EstebanUnal-Hub/VLSI-UNAL/Documents/ASIC_Flow/Bloques.png

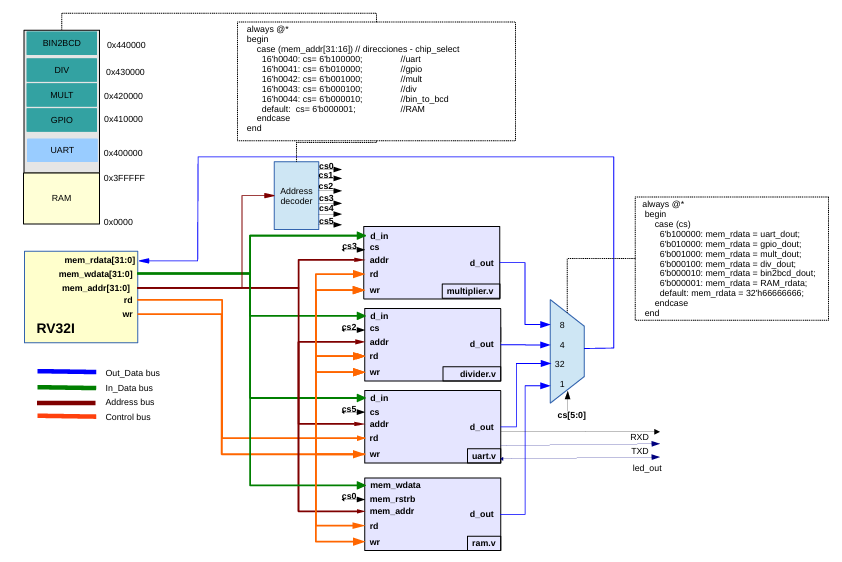
Documents/ASIC_Flow/Bloques.png
