EstebanUnal-Hub/VLSI-UNAL/Documents/Mult_4/Commands_Magis.png

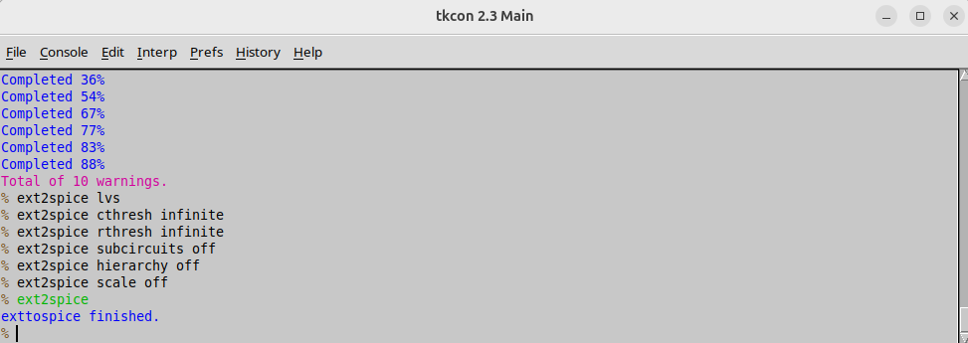
Documents/Mult_4/Commands_Magis.png
