EstebanUnal-Hub/VLSI-UNAL/Documents/SPICE/commands.png

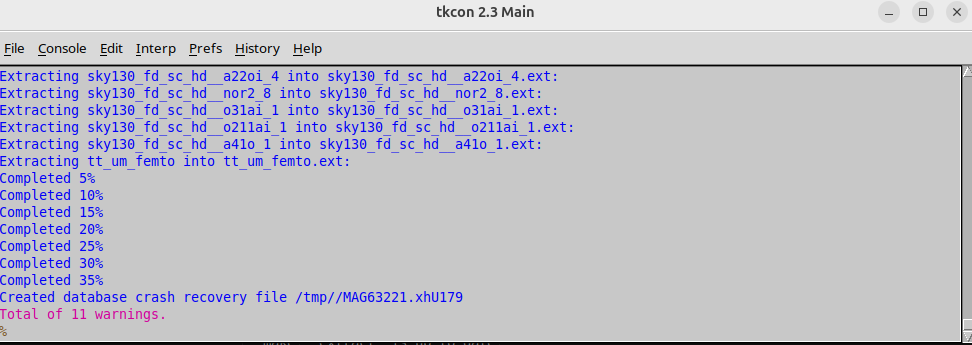
Documents/SPICE/commands.png
