EstebanUnal-Hub/VLSI-UNAL/Documents/SPICE/Otras.png

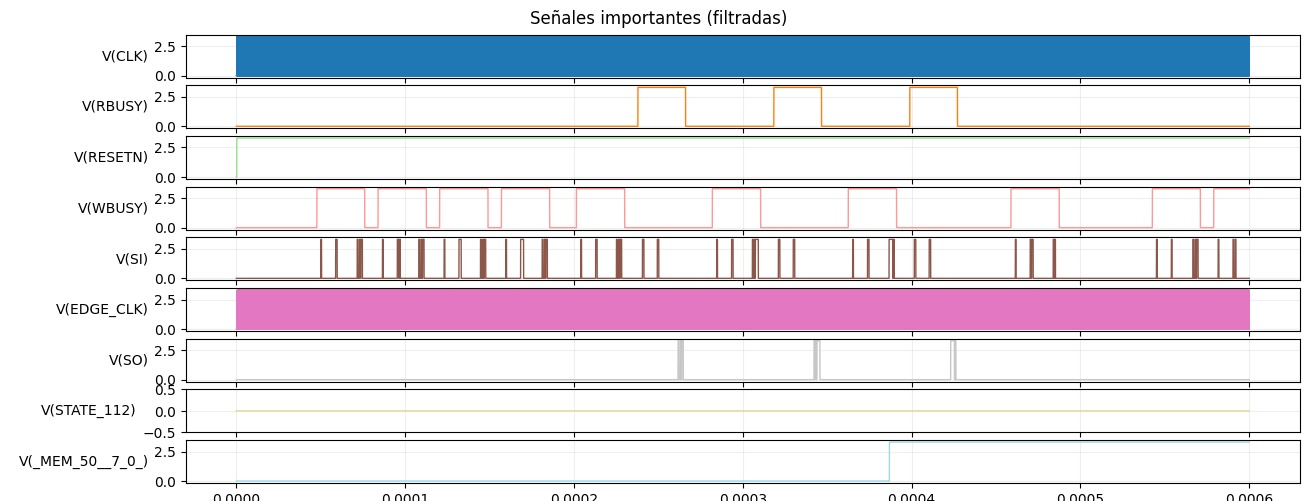
Documents/SPICE/Otras.png
