EstebanUnal-Hub/VLSI-UNAL/Documents/SPICE/PC.png

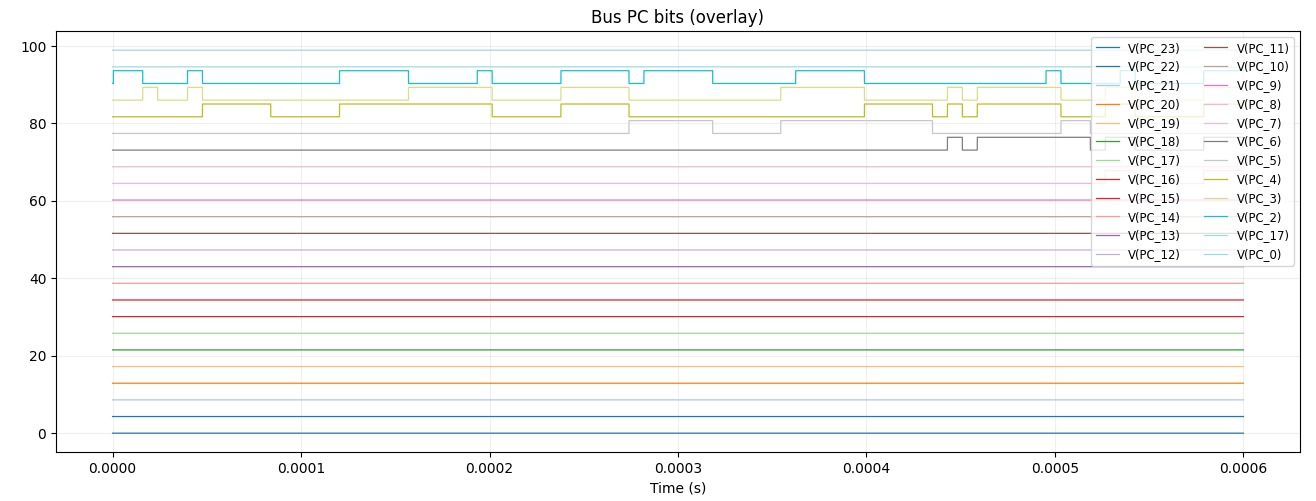
Documents/SPICE/PC.png
