EstebanUnal-Hub/VLSI-UNAL/Documents/SPICE/PC_INT.png

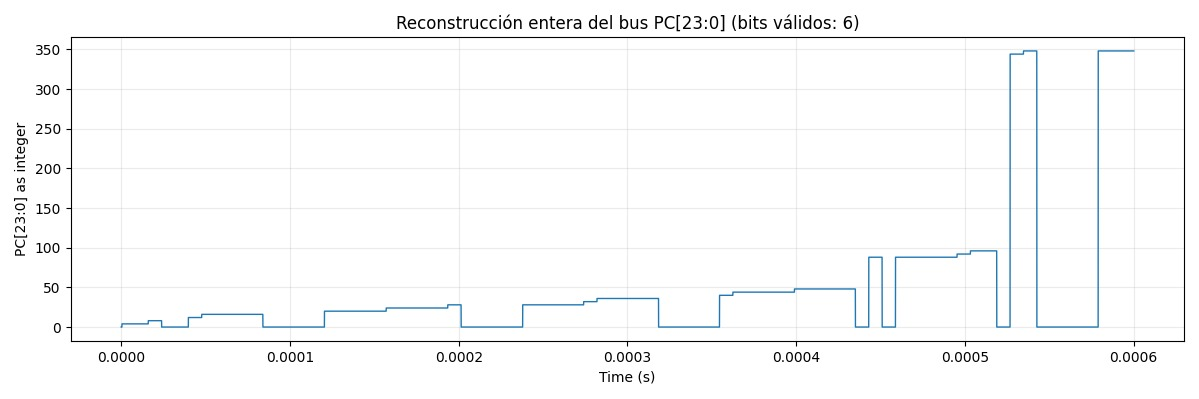
Documents/SPICE/PC_INT.png
