EstebanUnal-Hub/VLSI-UNAL/TT_Mult_4-main/src/acc.v

module acc (clk , A, add, rst, pp);
  input clk;
  input [7:0] A;
  input add;
  input rst; 
  output reg [7:0] pp;

initial pp = 0;

always @(negedge clk)
  if (rst) 
   pp = 32'h00000000;
  else
     begin
      if (add) pp = pp + A;
      else pp = pp;
     end
endmodule
