EstebanUnal-Hub/VLSI-UNAL/TT_Mult_4-main/src/rsr.v

module rsr (clk, in_B , shift , load , s_B);
  input clk;
  input [3:0]in_B;
  input load;
  input shift;
  output reg [7:0]s_B;

always @(negedge clk)
  if(load)
     s_B = in_B ;
  else
   begin
    if(shift) s_B = s_B >> 1;
    else s_B = s_B;
   end

endmodule
