EstebanUnal-Hub/VLSI-UNAL/mult_4_ASIC_Flow/mult_32_TB.v

`timescale 1ns / 1ps
`define SIMULATION
module mult_32_TB;
   reg  clk;
   reg  rst;
   reg  reset;
   reg  start;
   reg  [3:0]A;
   reg  [3:0]B;
   wire [7:0] pp;
   wire done;
   mult_32 uut (.clk(clk) , .rst(rst) , .init(start) , .A(A) , .B(B) , .pp(pp) , .done(done));
   parameter PERIOD          = 20;
   parameter real DUTY_CYCLE = 0.5;
   parameter OFFSET          = 0;
   reg [20:0] i;
	event reset_trigger;
	event reset_done_trigger;
	initial begin 
	  forever begin 
	   @ (reset_trigger);
    rst = 1;
		@ (negedge clk);
		rst = 1;
		@ (negedge clk);
		rst = 0;
		-> reset_done_trigger;
		end
	end
   initial begin  // Initialize Inputs
      clk = 0; rst = 1; start = 0; A = 16'h0003; B = 16'h0005;
   end
   initial  begin  // Process for clk
     #OFFSET;
     forever
       begin
         clk = 1'b0;
         #(PERIOD-(PERIOD*DUTY_CYCLE)) clk = 1'b1;
         #(PERIOD*DUTY_CYCLE);
       end
   end
   initial begin // Reset the system, Start the image capture process
        #10 -> reset_trigger;
        @ (reset_done_trigger);
        @ (posedge clk);
        start = 0;
        @ (posedge clk);
        start = 1;
       for(i=0; i<2; i=i+1) begin
         @ (posedge clk);
       end
          start = 0;
       for(i=0; i<17; i=i+1) begin
         @ (posedge clk);
       end
   end	 
   initial begin: TEST_CASE
     $dumpfile("mult_32_TB.vcd");
     $dumpvars(-1, uut);
     #((PERIOD*DUTY_CYCLE)*120) $finish;
   end
endmodule
