EstebanUnal-Hub/VLSI-UNAL/(commit log)

2025-12-06 it was fixed the mult_4 device
    [acc.v, lsr.v, mult_4.v, mult_4_TB.v, rsr.v]
2025-12-07 Update files in mult_4_ASIC_Flow to achieve PP (uo_out) output simulation of the device
